Tessy8/powerbank/pcb/powerbank_pcb.pdf

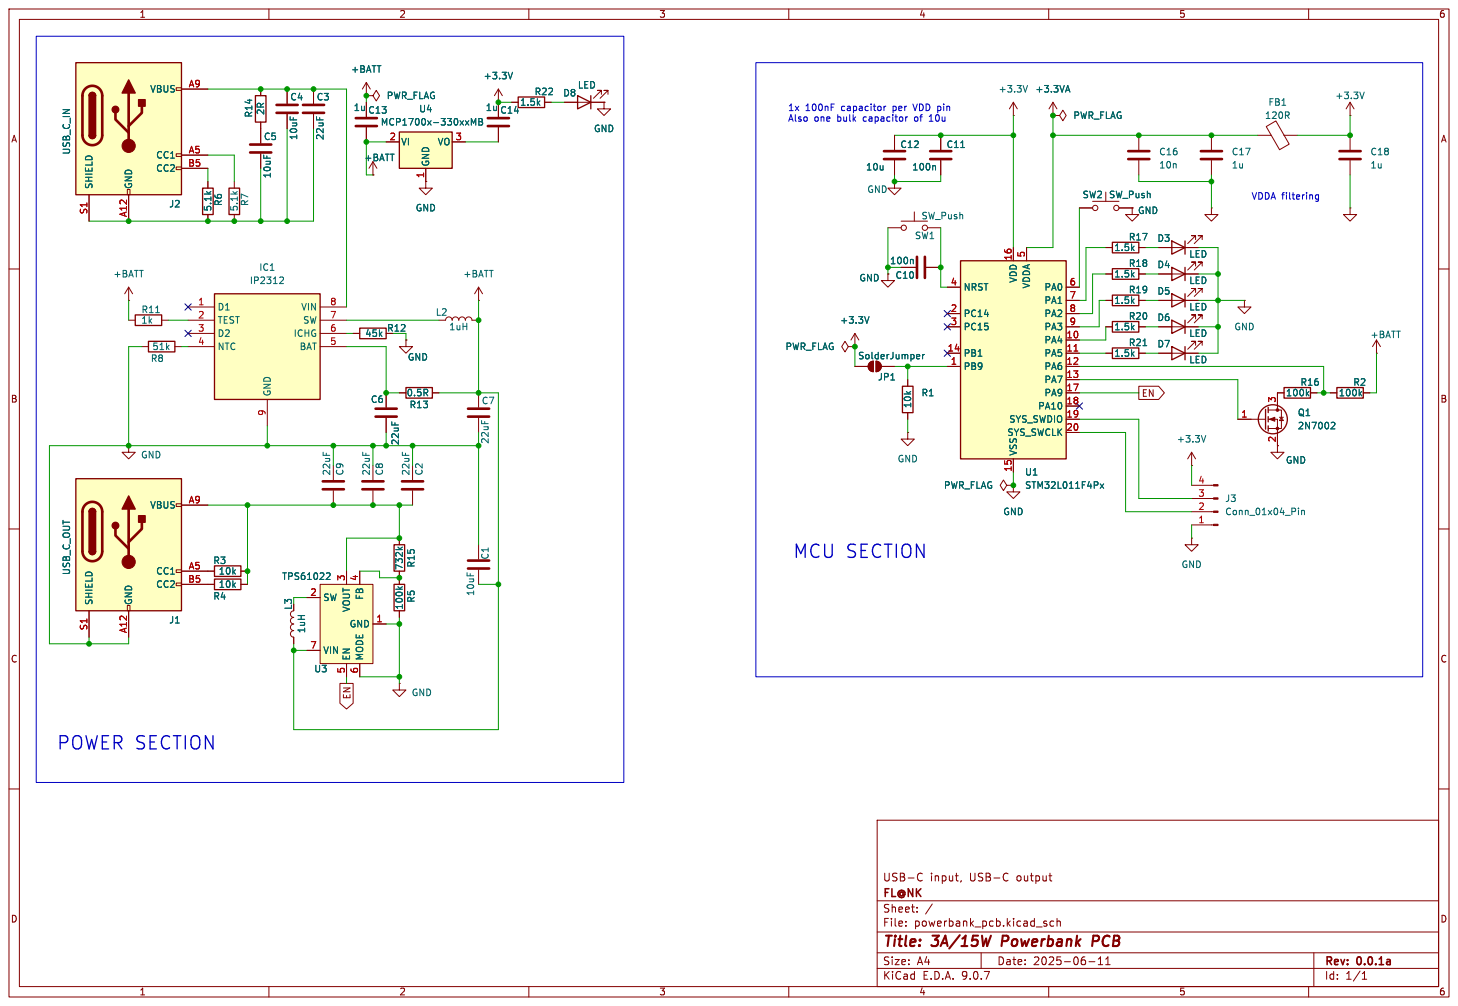
[picture p1: page 1]

6 VIN 7 GND 1 SW 2 VOUT

File: powerbank_pcb.kicad_sch Sheet: / FL@NK

Id: 1/1 Title: 3A/15W Powerbank PCB
