Tessy8/powerbank/pcb/kicad/powerbank_pcb.kicad_pcb

## KiCad design pcb/kicad/powerbank_pcb.kicad_pcb (2026-08-17)

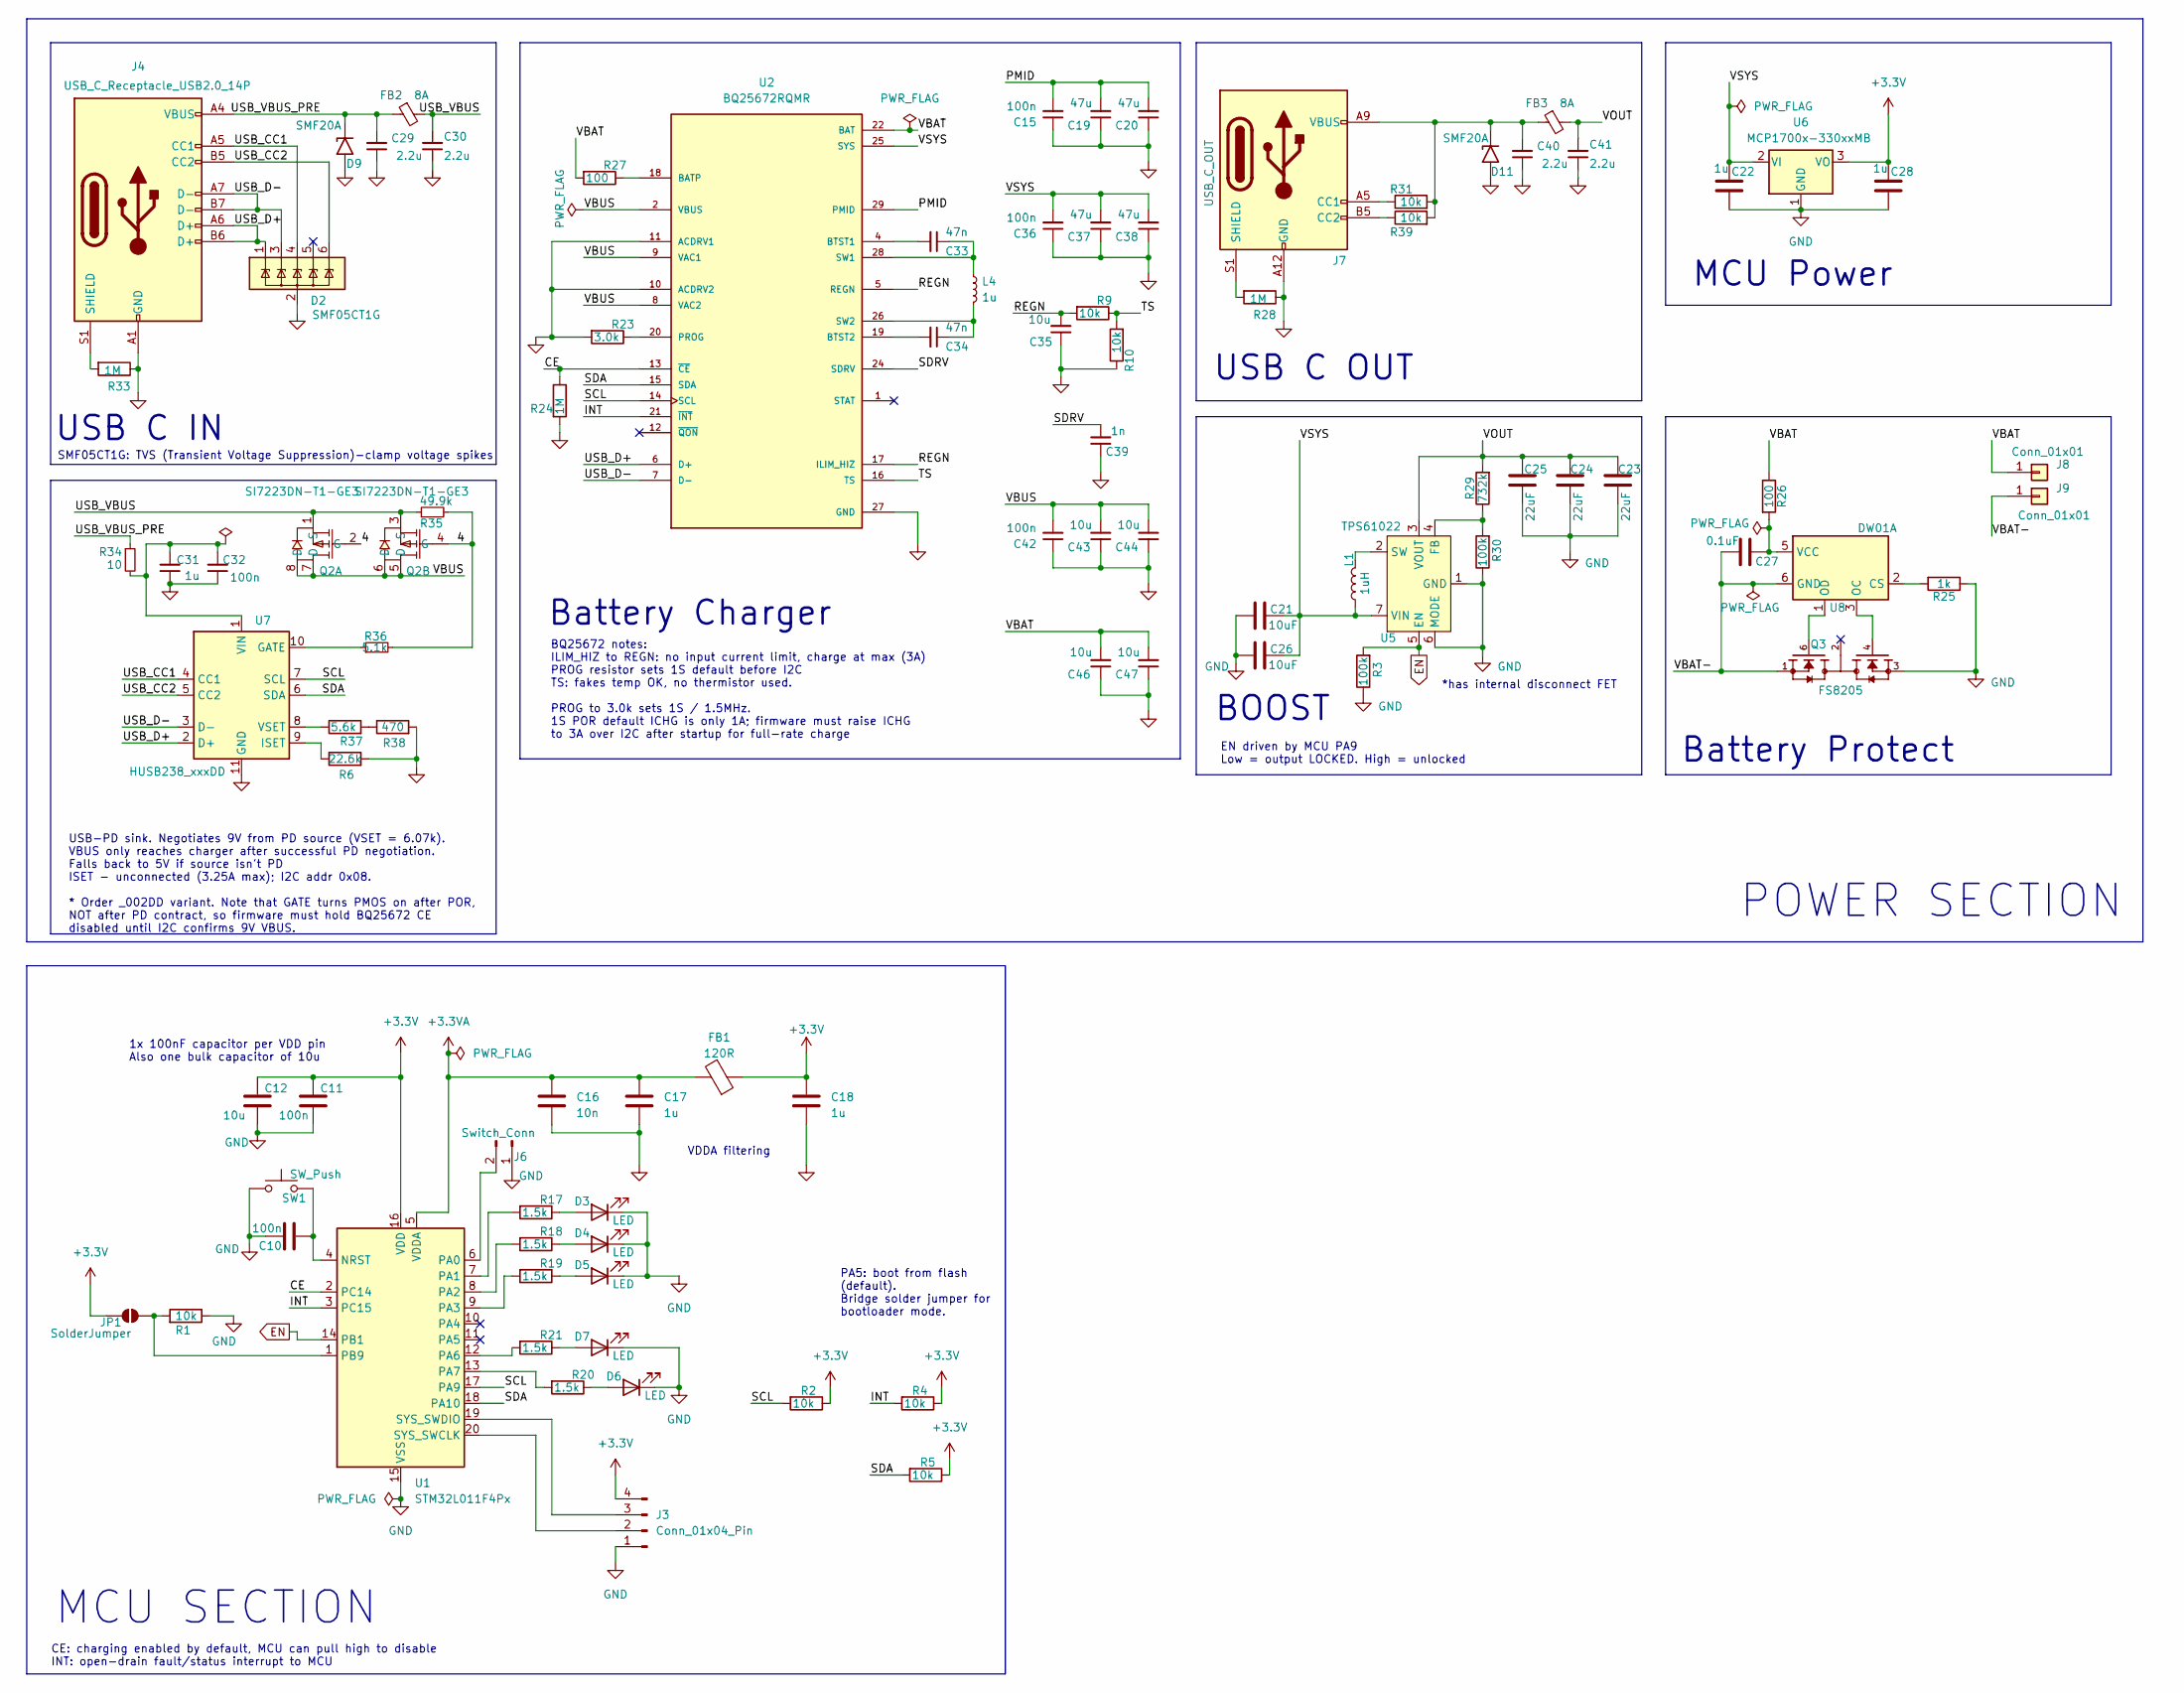
[picture p2: schematic powerbank_pcb.kicad_sch, Powerbank PCB]

Parts:
C10, C11, C32, C42: 100n; C_0603_1608Metric
C12, C35, C43, C44, C46, C47: 10u; C_0805_2012Metric
C15, C36: 100n; C_0805_2012Metric
C16: 10n; C_0603_1608Metric
C17, C18, C22, C28, C31: 1u; C_0603_1608Metric
C19, C20, C37, C38: 47u; C_0805_2012Metric
C21, C26: 10uF; C_0805_2012Metric
C23, C24, C25: 22uF; C_0805_2012Metric
C27: 0.1uF; C_0603_1608Metric
C29, C30, C40, C41: 2.2u; C_0603_1608Metric
C33, C34: 47n; C_0603_1608Metric
C39: 1n; C_0402_1005Metric
D2: SMF05CT1G; SOT-23-6
D3, D4, D5, D6, D7: LED; LED_0805_2012Metric
D9, D11: SMF20A; D_SMF
FB1: 120R; L_0805_2012Metric
FB2, FB3: 8A; L_0805_2012Metric
J3: Conn_01x04_Pin; PinHeader_1x04_P2.54mm_Vertical
J4: USB_C_Receptacle_USB2.0_14P; USB_C_Receptacle_GCT_USB4105-xx-A_16P_TopMnt_Horizontal
J6: Switch_Conn; PinHeader_1x02_P2.54mm_Vertical
J7: USB_C_OUT; USB_C_Receptacle_GCT_USB4125-xx-x_6P_TopMnt_Horizontal
J8, J9: Conn_01x01; TestPoint_THTPad_2.0x2.0mm_Drill1.0mm
JP1: SolderJumper; SolderJumper-2_P1.3mm_Open_RoundedPad1.0x1.5mm
L1: 1uH; L_Coilcraft_XAL7030-102
L4: 1u; L_Changjiang_FXL0530
Q2: SI7223DN-T1-GE3; PDFN3333-8_L3.1-W3.1-P0.65-LS3.4-BL-EP; MPN SI7223DN-T1-GE3; LCSC Part C17406449
Q3: FS8205; SOT95P280X145-6N; PARTREV 1.9
R1, R2, R4, R5, R31, R39: 10k; R_0603_1608Metric
R3, R30: 100k; R_0603_1608Metric
R6: 22.6k; R_0603_1608Metric
R9, R10: 10k; R_0805_2012Metric
R17, R18, R19, R20, R21: 1.5k; R_0603_1608Metric
R23: 3.0k; R_0603_1608Metric
R24, R28, R33: 1M; R_0603_1608Metric
R25: 1k; R_0603_1608Metric
R26, R27: 100; R_0603_1608Metric
R29: 732k; R_0603_1608Metric
R34: 10; R_0603_1608Metric
R35: 49.9k; R_0603_1608Metric
R36: 5.1k; R_0603_1608Metric
R37: 5.6k; R_0603_1608Metric
R38: 470; R_0603_1608Metric
SW1: SW_Push; SW_SPST_B3U-1000P
U1: STM32L011F4Px; TSSOP-20_4.4x6.5mm_P0.65mm
U2: BQ25672RQMR; IC_BQ25672RQMR; PARTREV A
U5: TPS61022; Texas_RWU0007A_VQFN-7_2x2mm_P0.5mm
U6: MCP1700x-330xxMB; SOT-89-3
U7: HUSB238_xxxDD; WDFN-10-1EP_3x3mm_P0.5mm_EP1.8x2.5mm
U8: DW01A; SOT-23-6

Connections:
+3.3V: C11.1, C12.1, C18.1, C28.1, FB1.1, J3.4, JP1.1 (A), R2.1, R4.1, R5.1, U1.16 (VDD), U6.3 (VO)
+3.3VA: C16.1, C17.1, FB1.2, U1.5 (VDDA)
/4: Q2.2 (G), Q2.4 (G), R35.2, R36.2
/CE: R24.1, U1.2 (PC14), U2.13 (~CE)
/INT: R4.2, U1.3 (PC15), U2.21 (~INT)
/PMID: C15.2, C19.2, C20.2, U2.29 (PMID)
/REGN: C35.2, R9.2, U2.5 (REGN), U2.17 (ILIM_HIZ)
/SCL: R2.2, U1.17 (PA9), U2.14 (SCL), U7.7 (SCL)
/SDA: R5.2, U1.18 (PA10), U2.15 (SDA), U7.6 (SDA)
/SDRV: C39.2, U2.24 (SDRV)
/TS: R9.1, R10.2, U2.16 (TS)
/USB_CC1: D2.4 (IO3), J4.A5 (CC1), U7.4 (CC1)
/USB_CC2: D2.6 (IO5), J4.B5 (CC2), U7.5 (CC2)
/USB_D+: D2.1 (IO1), J4.A6 (D+), J4.B6 (D+), U2.6 (D+), U7.2 (D+)
/USB_D-: D2.3 (IO2), J4.A7 (D-), J4.B7 (D-), U2.7 (D-), U7.3 (D-)
/USB_VBUS: C30.2, FB2.2, Q2.1 (S), Q2.3 (S), R35.1
/USB_VBUS_PRE: C29.2, D9.1 (A1), FB2.1, J4.A4 (VBUS), J4.A9 (VBUS), J4.B4 (VBUS), J4.B9 (VBUS), R34.1
/VBAT-: C27.2, J9.1, Q3.1, U8.6 (GND)
/VBUS: C42.2, C43.2, C44.2, Q2.5 (D), Q2.6 (D), Q2.7 (D), Q2.8 (D), U2.2 (VBUS), U2.3 (VBUS), U2.8 (VAC2), U2.9 (VAC1)
/VOUT: C23.2, C24.2, C25.2, C41.2, FB3.2, R29.2, U5.3 (VOUT)
/VSYS: C21.1, C22.1, C26.1, C36.2, C37.2, C38.2, L1.1, U2.25 (SYS), U5.7 (VIN), U6.2 (VI)
BAT: C46.2, C47.2, J8.1, R26.1, R27.2, U2.22 (BAT), U2.23 (BAT)
EN: R3.2, U1.14 (PB1), U5.5 (EN)
GND: C10.1, C11.2, C12.2, C15.1, C16.2, C17.2, C18.2, C19.1, C20.1, C21.2, C22.2, C23.1, C24.1, C25.1, C26.2, C28.2, C29.1, C30.1, C31.1, C32.1, C35.1, C36.1, C37.1, C38.1, C39.1, C40.1, C41.1, C42.1, C43.1, C44.1, C46.1, C47.1, D2.2 (GND), D3.1 (K), D4.1 (K), D5.1 (K), D6.1 (K), D7.1 (K), D9.2 (A2), D11.2 (A2), J3.1, J4.A1 (GND), J4.A12 (GND), J4.B1 (GND), J4.B12 (GND), J6.1, J7.A12 (GND), J7.B12 (GND), Q3.3, R1.1, R3.1, R6.2, R10.1, R23.2, R24.2, R25.1, R28.1, R30.1, R33.1, R38.2, SW1.1, U1.15 (VSS), U2.10 (ACDRV2), U2.11 (ACDRV1), U2.27 (GND), U5.1 (GND), U5.6 (MODE), U6.1 (GND), U7.11 (GND)
unnamed: D3.2 (A), R17.1
unnamed: D4.2 (A), R18.1
unnamed: D5.2 (A), R19.1
unnamed: D6.2 (A), R20.1
unnamed: D7.2 (A), R21.1
unnamed: C40.2, D11.1 (A1), FB3.1, J7.A9 (VBUS), J7.B9 (VBUS), R31.2, R39.2
unnamed: J3.2, U1.20 (SYS_SWCLK)
unnamed: J3.3, U1.19 (SYS_SWDIO)
unnamed: J4.S1 (SHIELD), R33.2
unnamed: J6.2, U1.6 (PA0)
unnamed: J7.A5 (CC1), R31.1
unnamed: J7.B5 (CC2), R39.1
unnamed: J7.S1 (SHIELD), R28.2
unnamed: JP1.2 (B), R1.2, U1.1 (PB9)
unnamed: R37.2, R38.1
unnamed: C10.2, SW1.2, U1.4 (NRST)
unnamed: R17.2, U1.7 (PA1)
unnamed: R18.2, U1.8 (PA2)
unnamed: R19.2, U1.9 (PA3)
unnamed: R21.2, U1.12 (PA6)
unnamed: R20.2, U1.13 (PA7)
unnamed: R27.1, U2.18 (BATP)
unnamed: C33.2, U2.4 (BTST1)
unnamed: C34.2, U2.19 (BTST2)
unnamed: R23.1, U2.20 (PROG)
unnamed: C33.1, L4.1, U2.28 (SW1)
unnamed: C34.1, L4.2, U2.26 (SW2)
unnamed: R29.1, R30.2, U5.4 (FB)
unnamed: L1.2, U5.2 (SW)
unnamed: R36.1, U7.10 (GATE)
unnamed: R6.1, U7.9 (ISET)
unnamed: C31.2, C32.2, R34.2, U7.1 (VIN)
unnamed: R37.1, U7.8 (VSET)
unnamed: R25.2, U8.2 (CS)
unnamed: Q3.4, U8.3 (OC)
unnamed: Q3.6, U8.1 (OD)
unnamed: C27.1, R26.2, U8.5 (VCC)

Notes on the sheet:
MCU SECTION
BQ25672 notes: ILIM_HIZ to REGN: no input current limit, charge at max (3A) PROG resistor sets 1S default before I2C TS: fakes temp OK, no thermistor used. PROG to 3.0k sets 1S / 1.5MHz. 1S POR default ICHG is only 1A; firmware must raise ICHG to 3A over I2C after startup for full-rate charge
POWER SECTION
CE: charging enabled by default, MCU can pull high to disable INT: open-drain fault/status interrupt to MCU
Battery Protect
BOOST
USB C OUT
EN driven by MCU PA9 Low = output LOCKED. High = unlocked
VDDA filtering
SMF05CT1G: TVS (Transient Voltage Suppression)-clamp voltage spikes
PA5: boot from flash (default). Bridge solder jumper for bootloader mode.
USB C IN
MCU Power
*has internal disconnect FET
1x 100nF capacitor per VDD pin Also one bulk capacitor of 10u
USB-PD sink. Negotiates 9V from PD source (VSET = 6.07k). VBUS only reaches charger after successful PD negotiation. Falls back to 5V if source isn't PD ISET - unconnected (3.25A max); I2C addr 0x08. * Order _002DD variant. Note that GATE turns PMOS on after POR, NOT after PD contract, so firmware 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
Battery Charger

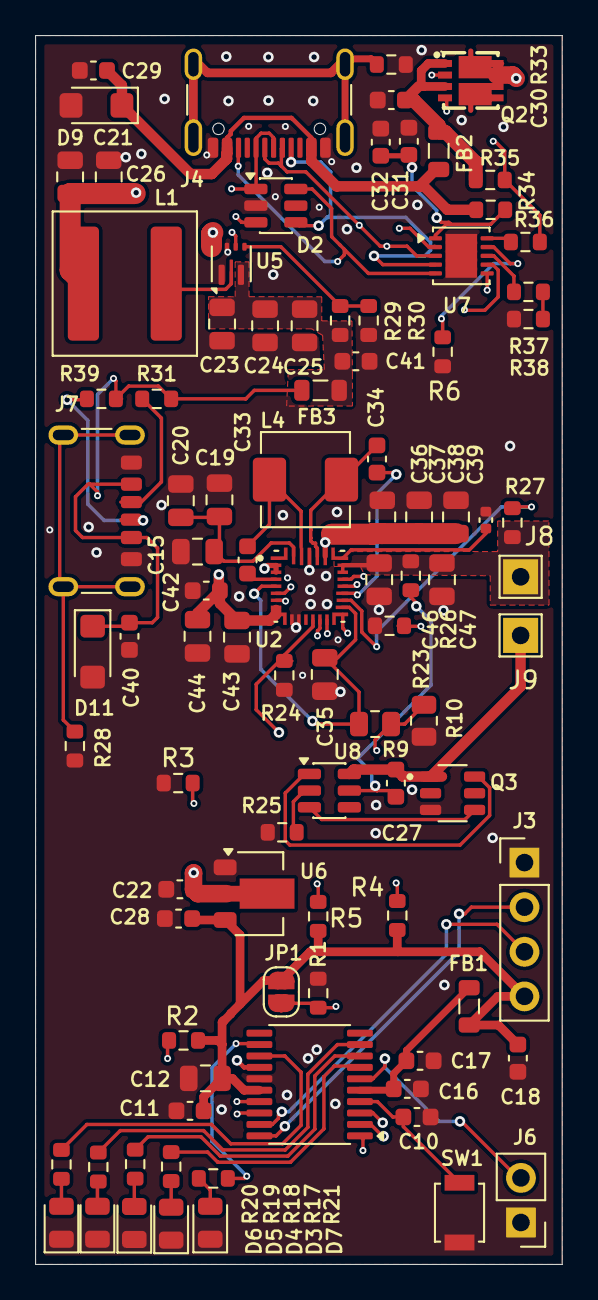
[picture p3: board powerbank_pcb.kicad_pcb from above]

Board: 4 copper layers, 30.0 x 70.0 mm, 93 parts (0 on the bottom side), 61 nets.
